engirati/smart-bbq/Bill of Materials/smartbbq-bom-v1.xlsx

Qty | Value | Device | Package | Parts | Description | Manufacturer | Manufacturer P/N | Supplier | Supplier P/N
1 |  | DISP_SEGMENT_4DIGIT_BL-Q56C43 | SEGMENT-BL-Q56C43 | LED1 |  | Luckylight | KW4-56NXLB-P | Adafruit | 865 (https://www.adafruit.com/products/865)
1 |  | HT16K33_SOP28 | SOP28_300MIL | U1 |  | Holtek | HT16K33 | Keyan Technology Co.,Ltd | 1240179945 (http://www.aliexpress.com/item/10PCS-LOT-HT16K33-SOP28/1240179945.html)
4 |  | LEDCHIPLED_0805 | CHIPLED_0805 | LED2, LED3, LED4, LED5 | LED | Lite-On Inc | LTST-C171KRKT | Digi-Key | 160-1427-1-ND (http://www.digikey.com/scripts/DkSearch/dksus.dll?Detail&itemSeq=152365748&uq=635392288186029003)
3 |  | PANASONIC-EVQ | PANASONIC-EVQ | S1,S2, S3 |  | Panasonic | EVQ-Q2K03W | Digi-Key | P12943SCT-ND (http://www.digikey.com/scripts/DkSearch/dksus.dll?Detail&itemSeq=152657065&uq=635398546741208389)
2 | + | 22-05-7028-02 | 7395-02 | J8, J9 | CONNECTOR | 3M | 961102-6404-AR | Digi-Key | 3M9447-ND (http://www.digikey.com/scripts/DkSearch/dksus.dll?Detail&itemSeq=152834292&uq=635398549900052389)
9 | 10K | R-US_R0805 | R0805 | R1, R2, R3, R4, R9, R10, R14, R25, R26 | RESISTOR, American symbol | Yageo | RC0805JR-0710KL | Digi-Key | 311-10KARCT-ND (http://www.digikey.com/product-detail/en/RC0805JR-0710KL/311-10KARCT-ND/731188)
3 | 10uF | C-USC0805 | C0805 | C5, C6, C7 | CAPACITOR, American symbol | Samsung Electro-Mechanics America, Inc | CL21A106KOQNNNE | Digi-Key | 1276-1096-1-ND (http://www.digikey.com/scripts/DkSearch/dksus.dll?Detail&itemSeq=152434732&uq=635392322803423238)
10 | 1K | R-US_R0805 | R0805 | R12, R15, R16, R17, R19, R20, R21, R22, R23, R24 | RESISTOR, American symbol | Yageo | RC0805JR-071KL | Digi-Key | 311-1.0KARCT-ND (http://www.digikey.com/product-detail/en/RC0805JR-071KL/311-1.0KARCT-ND/731165)
4 | 1uF | C-USC0805 | C0805 | C1, C2, C3, C4 | CAPACITOR, American symbol | Samsung Electro-Mechanics America, Inc | CL21B105KAFNNNE | Digi-Key | 1276-1066-1-ND (http://www.digikey.com/product-detail/en/CL21B105KAFNNNE/1276-1066-1-ND/3889152)
1 | 2920L300-15DR | 2920L300-15DR | 2920L300-15DR | F1 |  | Littelfuse Inc | 2920L300/15DR | Digi-Key | F2875CT-ND (http://www.digikey.com/scripts/DkSearch/dksus.dll?Detail&itemSeq=152443413&uq=635398536818994616)
6 | 330 | R-US_R0805 | R0805 | R5, R6, R7, R8, R13, R18 | RESISTOR, American symbol | Yageo | RC0805JR-07330RL | Digi-Key | 311-330ARCT-ND (http://www.digikey.com/product-detail/en/RC0805JR-07330RL/311-330ARCT-ND/731258)
1 | 5.5od/2.1id | PJ_002AH_SMT | PJ_002AH_SMT | J5 | MODEL: PJ-002AH-SMT or PJ-002BH-SMT | CUI Inc | PJ-002AH-SMT-TR | Digi-Key | CP-002AHPJCT-ND (http://www.digikey.com/product-detail/en/PJ-002AH-SMT-TR/CP-002AHPJCT-ND/669692)
2 | 5.5od/2.5id | PJ_002AH_SMT | PJ_002AH_SMT | J6, J7 | MODEL: PJ-002AH-SMT or PJ-002BH-SMT | CUI Inc | PJ-002BH-SMT-TR | Digi-Key | CP-002BHPJCT-ND (http://www.digikey.com/product-detail/en/PJ-002BH-SMT-TR/CP-002BHPJCT-ND/669694)
1 | CMT_1603_SMT | CMT_1603_SMT | CMT_1603_SMT | P1 |  | CUI Inc | CMT-1603-SMT-TR | Digi-Key | 102-1193-2-ND (http://www.digikey.com/product-detail/en/CMT-1603-SMT-TR/102-1193-2-ND/504816)
4 | FAIRCHILD_S1A_SMT | FAIRCHILD_S1A_SMT | FAIRCHILD_S1A_SMT | D1, D2, D3, D4 |  | Fairchild Semiconductor | S1A | Digi-Key | S1AFSCT-ND (http://www.digikey.com/scripts/DkSearch/dksus.dll?Detail&itemSeq=152356511&uq=635392202216537957)
4 | MJ_2523_SMT | MJ_2523_SMT | MJ_2523_SMT | J1, J2, J3, J4 |  | CUI Inc | MJ-2523-SMT | Digi-Key | CP-2523MJCT-ND (http://www.digikey.com/scripts/DkSearch/dksus.dll?Detail&itemSeq=152345379&uq=635392345193733003)
1 | SPARK_CORECORE | SPARK_CORECORE | SPARK_CORE | SPARK |  | Spark |  | Spark
1 | SSM6N58NU | SSM6N58NU | SSM6N58NU | Q1 |  | Toshiba Semiconductor and Storage | SSM6N58NU,LF | Digi-Key | SSM6N58NULFCT-ND (http://www.digikey.com/scripts/DkSearch/dksus.dll?Detail&itemSeq=152676566&uq=635398550861095831)
1 | TLV1117-50IDCY | TLV1117-33IDCY | SOT230P700X180-4N | U2 | V REG, LDO, 3.3V, 0.8A | Texas Instruments | TLV1117-50IDCYR | Digi-Key | 296-21115-1-ND (http://www.digikey.com/scripts/DkSearch/dksus.dll?Detail&itemSeq=152592245&uq=635398550861095831)
