engirati/smart-bbq/hardware/eagle/smartbbq.brd

## EAGLE design hardware/eagle/smartbbq.brd (2014-07-01)

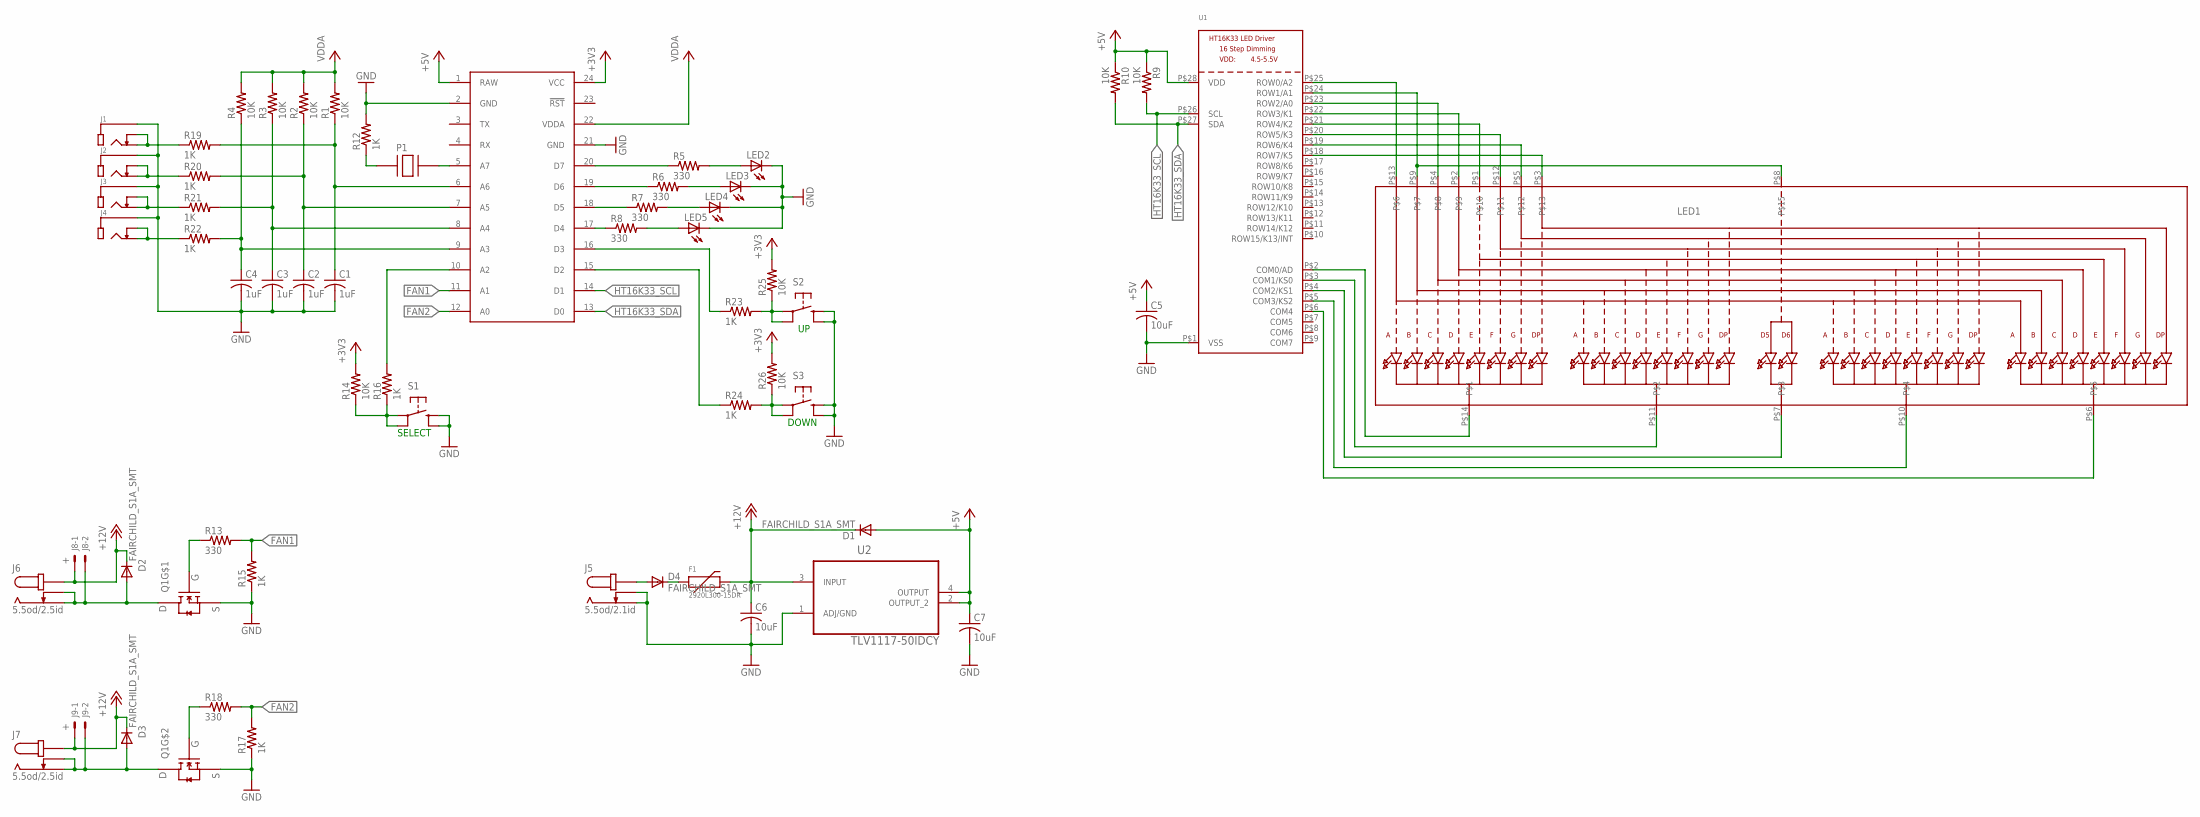
[picture p1: schematic smartbbq.sch]

Parts:
C1, C2, C3, C4: 1uF; C0805
C5, C6, C7: 10uF; C0805
D1, D2, D3, D4: FAIRCHILD_S1A_SMT
F1: 2920L300-15DR
J1, J2, J3, J4: MJ_2523_SMT
J5: 5.5od/2.1id; PJ_002AH_SMT
J6, J7: 5.5od/2.5id; PJ_002AH_SMT
J8, J9: +; 7395-02
LED1: DISP_SEGMENT_4DIGIT_BL-Q56C43; SEGMENT-BL-Q56C43
LED2, LED3, LED4, LED5: LEDCHIPLED_0805; CHIPLED_0805
P1: CMT_1603_SMT
Q1: SSM6N58NU
R1, R2, R3, R4, R9, R10, R14, R25, R26: 10K; R0805
R5, R6, R7, R8, R13, R18: 330; R0805
R12, R15, R16, R17, R19, R20, R21, R22, R23, R24: 1K; R0805
S1, S2, S3: PANASONIC-EVQ
SPARK: SPARK_CORECORE; SPARK_CORE
U1: HT16K33_SOP28; SOP28_300MIL
U2: TLV1117-50IDCY; SOT230P700X180-4N

Connections:
+3V3: R14.2, R25.2, R26.2, SPARK.24 (VCC)
+5V: C5.1, C7.1, D1.P$1 (A), R9.1, R10.1, SPARK.1 (RAW), U1.P$28 (VDD), U2.2 (OUTPUT_2), U2.4 (OUTPUT)
+12V: C6.1, D1.P$2 (C), D2.P$2 (C), D3.P$2 (C), F1.P$2, J6.P$1, J6.P$4, J7.P$1, J7.P$4, J8.1, J9.1, U2.3 (INPUT)
A0: LED1.P$4, U1.P$23 (ROW2/A0)
A1: LED1.P$8, LED1.P$9, U1.P$24 (ROW1/A1)
FAN1: R13.2, R15.2, SPARK.11 (A1)
FAN2: R17.2, R18.2, SPARK.12 (A0)
GND: C1.2, C2.2, C3.2, C4.2, C5.2, C6.2, C7.2, J1.P$1, J2.P$1, J3.P$1, J4.P$1, J5.P$2, J5.P$3, LED2.C, LED3.C, LED4.C, LED5.C, Q1.P$1, Q1.P$4, R12.2, R15.1, R17.1, S1.P$3 (3), S1.P$4 (4), S2.P$3 (3), S2.P$4 (4), S3.P$3 (3), S3.P$4 (4), SPARK.2 (GND), SPARK.21 (GND), U1.P$1 (VSS), U2.1 (ADJ/GND)
HT16K33_SCL: R9.2, SPARK.14 (D1), U1.P$26 (SCL)
HT16K33_SDA: R10.2, SPARK.13 (D0), U1.P$27 (SDA)
unnamed: LED1.P$14, U1.P$2 (COM0/AD)
unnamed: LED1.P$11, U1.P$3 (COM1/KS0)
unnamed: LED1.P$10, U1.P$5 (COM3/KS2)
unnamed: LED1.P$7, U1.P$4 (COM2/KS1)
unnamed: R8.1, SPARK.17 (D4)
unnamed: R7.1, SPARK.18 (D5)
unnamed: R6.1, SPARK.19 (D6)
unnamed: R5.1, SPARK.20 (D7)
unnamed: LED2.A, R5.2
unnamed: LED3.A, R6.2
unnamed: LED4.A, R7.2
unnamed: LED5.A, R8.2
unnamed: R24.1, SPARK.15 (D2)
unnamed: R23.1, SPARK.16 (D3)
unnamed: C1.1, R1.1, R19.2, SPARK.6 (A6)
unnamed: R16.2, SPARK.10 (A2)
unnamed: C2.1, R2.1, R20.2, SPARK.7 (A5)
unnamed: C3.1, R3.1, R21.2, SPARK.8 (A4)
unnamed: C4.1, R4.1, R22.2, SPARK.9 (A3)
unnamed: LED1.P$12, U1.P$20 (ROW5/K3)
unnamed: LED1.P$5, U1.P$19 (ROW6/K4)
unnamed: LED1.P$6, U1.P$6 (COM4)
unnamed: LED1.P$2, U1.P$22 (ROW3/K1)
unnamed: LED1.P$1, U1.P$21 (ROW4/K2)
unnamed: LED1.P$13, U1.P$25 (ROW0/A2)
unnamed: LED1.P$3, U1.P$18 (ROW7/K5)
unnamed: P1.P$1, R12.1
unnamed: P1.P$2, SPARK.5 (A7)
unnamed: D3.P$1 (A), J7.P$2, J7.P$3, J9.2, Q1.P$3
unnamed: Q1.P$5, R18.1
unnamed: D2.P$1 (A), J6.P$2, J6.P$3, J8.2, Q1.P$6
unnamed: D4.P$2 (C), F1.P$1
unnamed: Q1.P$2, R13.1
unnamed: R14.1, R16.1, S1.P$1 (1), S1.P$2 (2)
unnamed: J4.P$2, J4.P$3, R22.1
unnamed: J3.P$2, J3.P$3, R21.1
unnamed: J2.P$2, J2.P$3, R20.1
unnamed: J1.P$2, J1.P$3, R19.1
unnamed: R23.2, R25.1, S2.P$1 (1), S2.P$2 (2)
unnamed: D4.P$1 (A), J5.P$1, J5.P$4
unnamed: R24.2, R26.1, S3.P$1 (1), S3.P$2 (2)
VCC: R1.2, R2.2, R3.2, R4.2, SPARK.22 (VDDA)

Notes on the sheet:
DOWN
SELECT

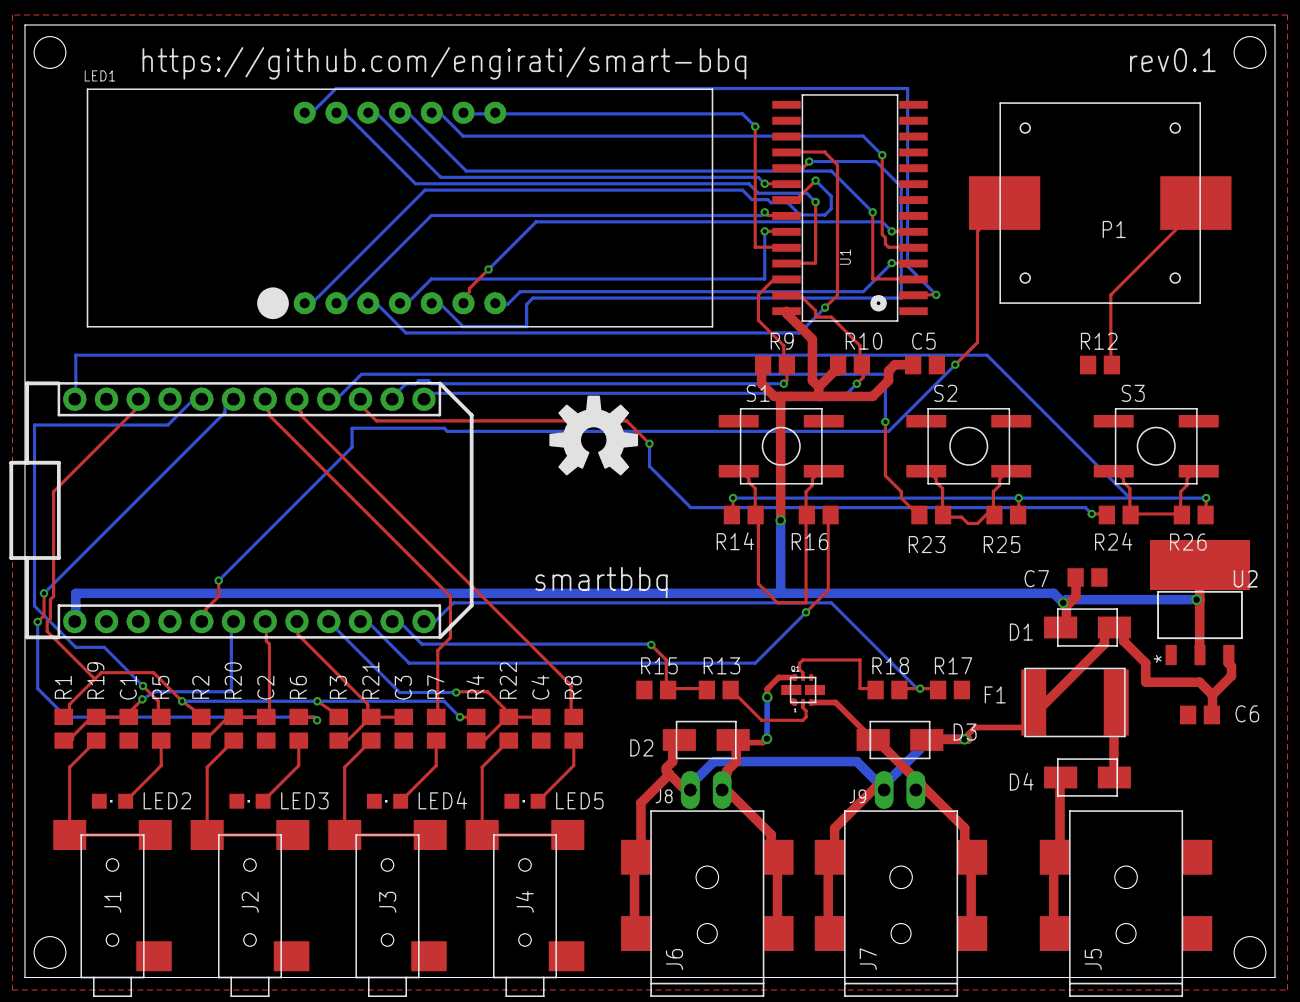
[picture p2: board smartbbq.brd from above]

Board: 2 copper layers, 100.0 x 76.2 mm, 60 parts (0 on the bottom side), 52 nets.

Other parts of the board:
U$1: OSHW-LOGO-L
