engirati/smart-bbq/(commit log)

2014-06-08 Initial firmware and schematic
    [smartbbq.sch]
2014-06-10 LCD & driver
    LCD, driver, values added and various other updates.
    [smartbbq.sch]
2014-06-11 Piezo addition
    [smartbbq.sch]
2014-06-16 Fans, power, misc
    Added fan output and power circuitry. Cleaned up a few random things.
    Swapped 0603 parts for 0805.
    [smartbbq.sch]
2014-06-19 Change fan driver circuitry
    Updated fan driver circuitry to use single MOSFET.
    [smartbbq.sch]
2014-06-23 Multiple updates. See description.
    Looks good! I will suggest a few things though:
    1.Probe inputs looks like maybe 2.5 or 3.5mm jacks. Connect the TIP to
    the analog input, and the SLEEVE or RING to GND. That way ESD has a
    harder path into you Spark Core inputs.
    I connected the tip and NC switch to analog in and the sleeve to gnd.
    2.It might be a good idea to do a Low Pass RC filter with the inputs in
    a different way so that you have a resistor always in series with the
    analog input. A 1k and 1uF should be plenty fast for temperature
    sensors. Then you still have your 10k pull up and thermistor pulldown on
    the front end. Assuming the impedance of the ADC input is high, you
    won't get much of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
    [smartbbq.sch]
2014-06-24 Added resistors and tweaked values
    Added missing select switch resistors and changed probe input resistor
    values.
    [smartbbq.sch]
2014-06-28 PCB added
    PCB added and a few schematic tweaks
    [smartbbq.brd, smartbbq.sch]
2014-07-01 rev0.1 of board
    rev0.1 of board and minor schematic edits
    [smartbbq.brd, smartbbq.sch]
2014-07-01 Heatsink pads added
    Added larger pads to act as a heatsink for voltage regulator and mosfet.
    [smartbbq.brd]
2014-07-02 Datasheets and bom
    [smartbbq-bom-v1.xlsx]
2014-08-13 PID & bugs
    Addition of PID hard coded to temp alarm on probe 4 for testing. Added
    alarm logic when up/down buttons are pressed. Created API variables.
    Fixed thermistor bug and display bug.
    [PID.cpp, PID.h, SmartBbq.cpp, SmartBbq.h, SmartProbe.h, ThermistorProbe.cpp, ThermistorProbe.h, smartbbq.ino]
2014-08-13 Missed a file
    Missed SmartProbe.cpp last commit
    [SmartProbe.cpp]
